Third-Millennium-Farming/domestic-cricket-reactor/README.md

domestic-cricket-reactor
========================

An inexpensive and easy to build cricket reactor for your home.  

for more infomrmation please visit. http://www.thirdmillenniumfarming.com/4.-Products.Cricket-Reactor.Features.html
