Third-Millennium-Farming/domestic-cricket-reactor/(list of files, cad)

Other CAD files:
02. June29.3dPrint.dwg
01. June29.LaserCut.dwg
