Third-Millennium-Farming/domestic-cricket-reactor/03. Assembly Manual.pdf

# MATERIALS LIST

Obtain the following materials before begining assembly:

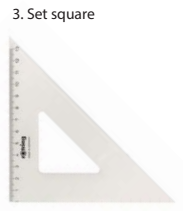
[picture p1: figure]

1. Acrylic Glue | 2. Acrylic Glue Syringe | 3. Set square

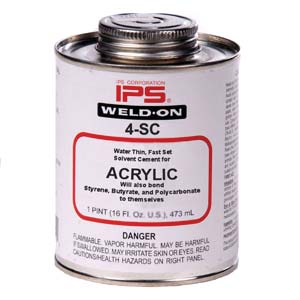
[picture p2: figure]

For acrylic gluing instructions, review the below video link: https://www.youtube.com/watch?v=hT6Ow_cBTps

4. Glue gun and glue stick

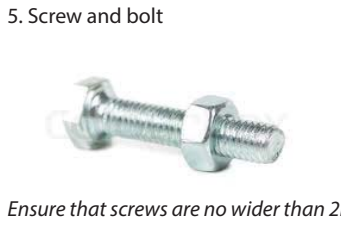
[picture p3: figure]
5. Screw and bolt

Ensure that screws are no wider than 2mm, and at least 15mm long.

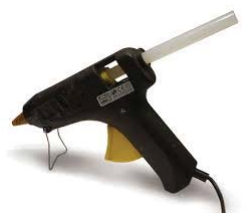
[picture p4: figure]

# PLEXI-GLASS PART LIST

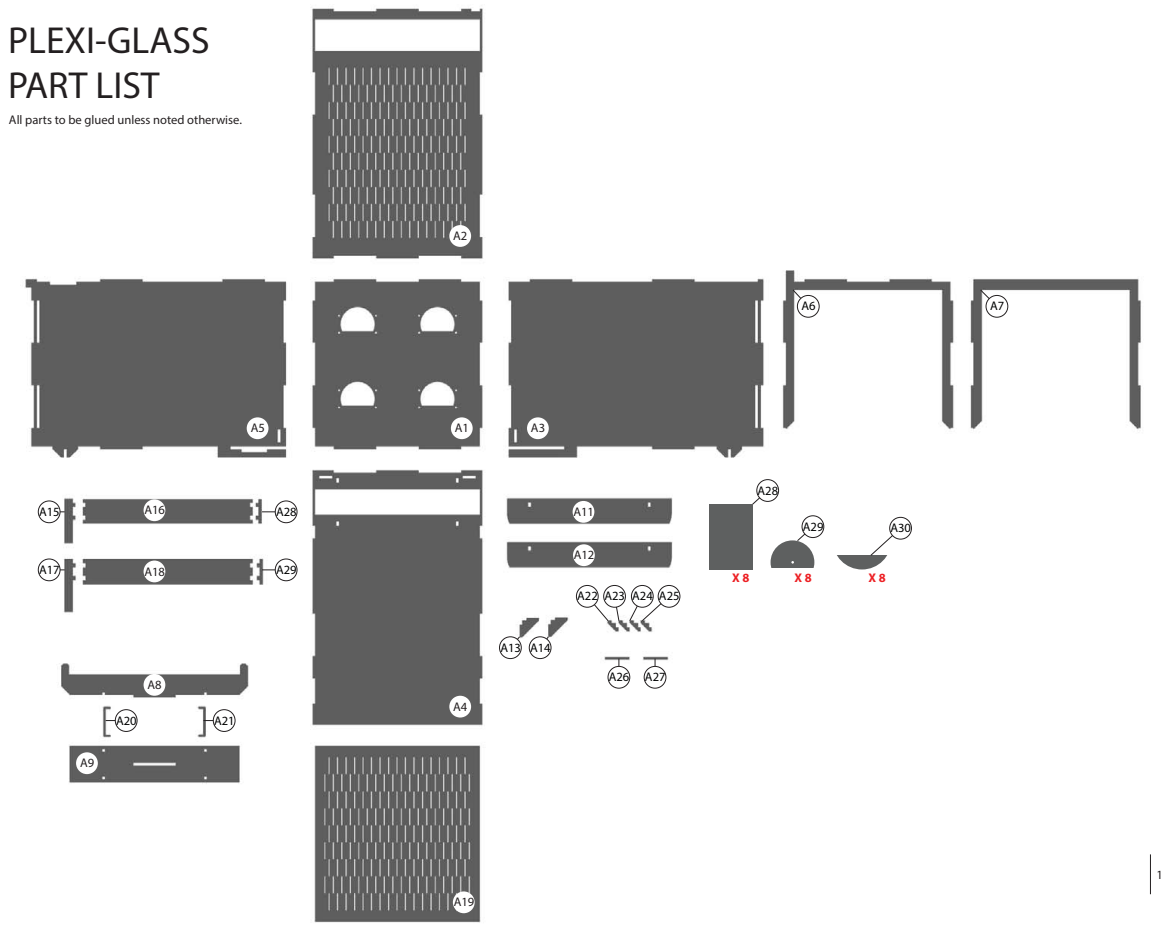
[picture p5: page 2]

All parts to be glued unless noted otherwise.

01 02

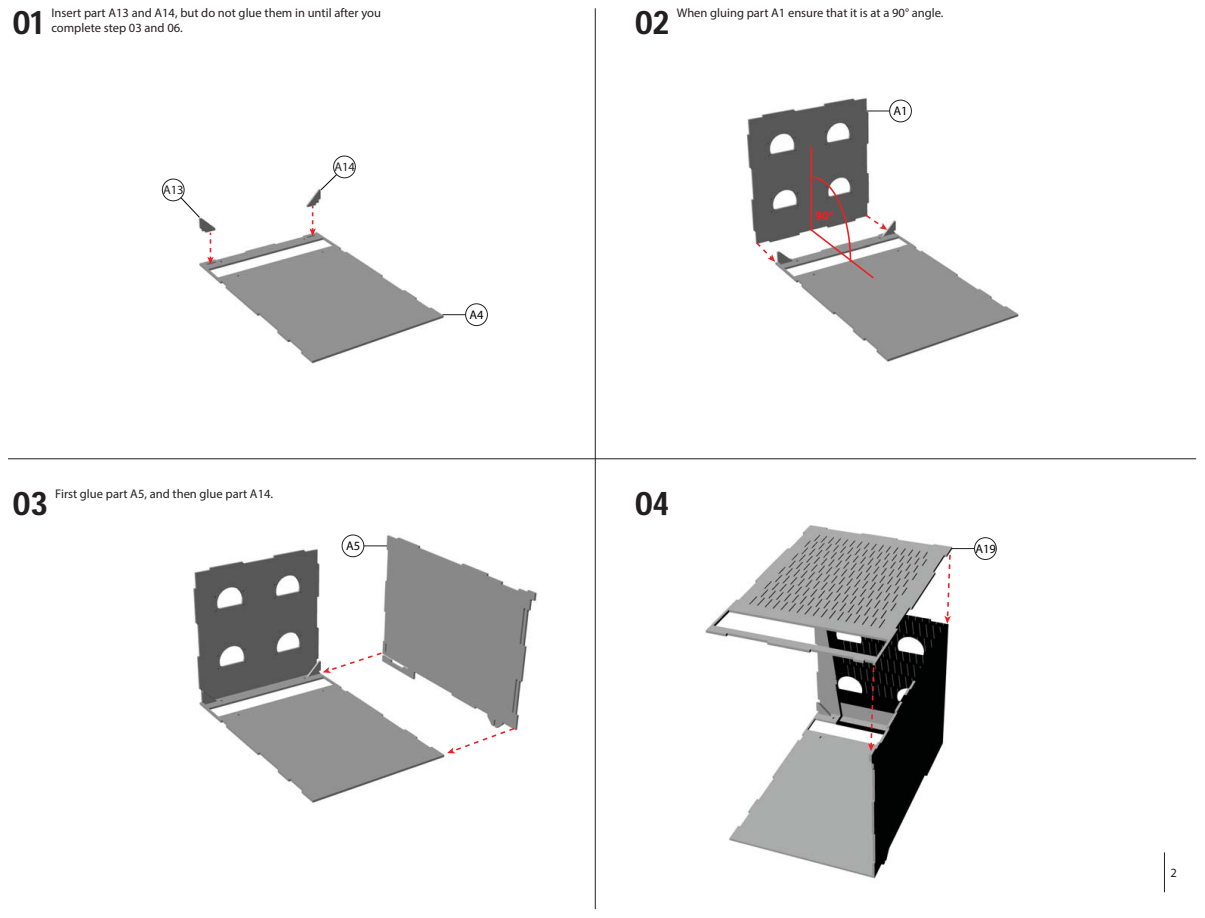
[picture p6: page 3]

Insert part A13 and A14, but do not glue them in until after you
complete step 03 and 06.

When gluing part A1 ensure that it is at a 90° angle.

First glue part A5, and then glue part A14.

06

05

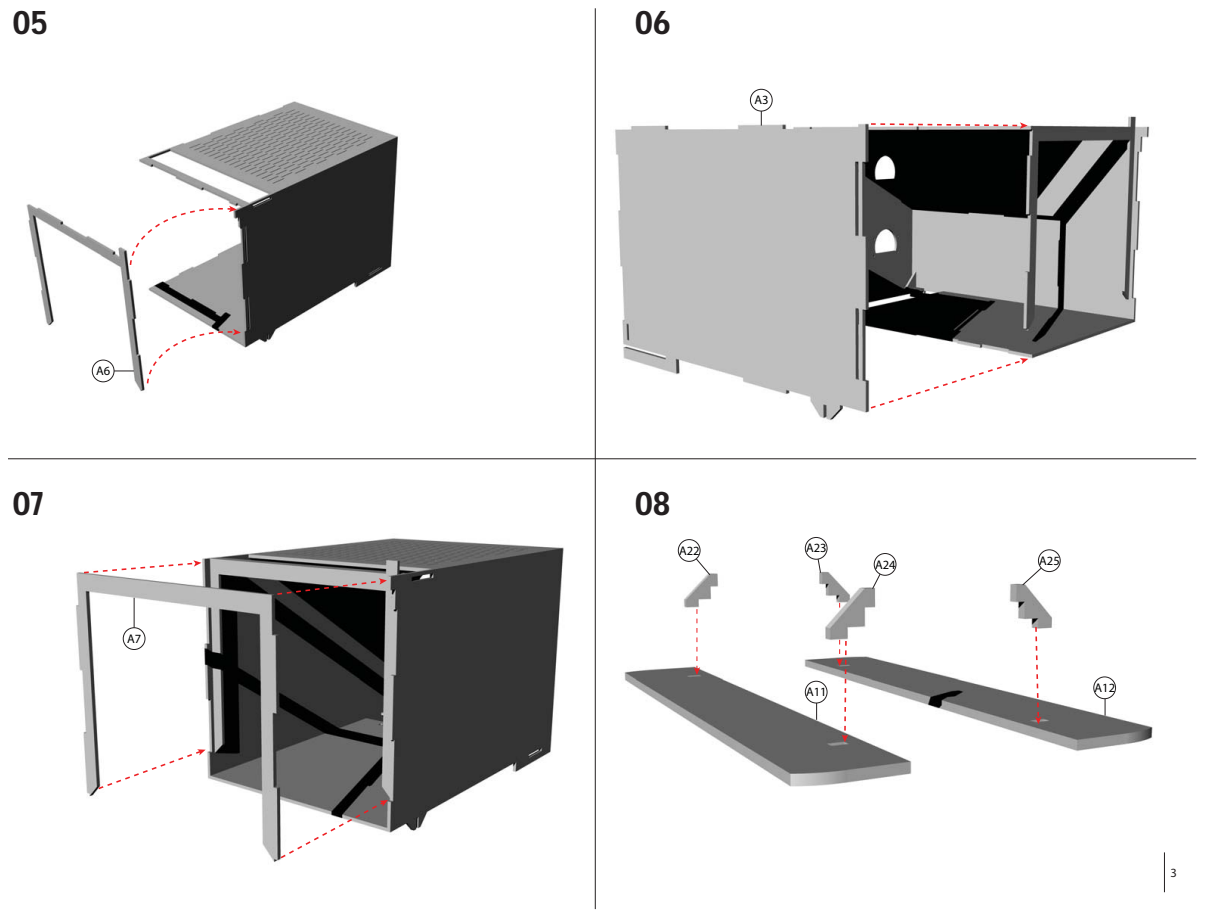
[picture p7: page 4]

10

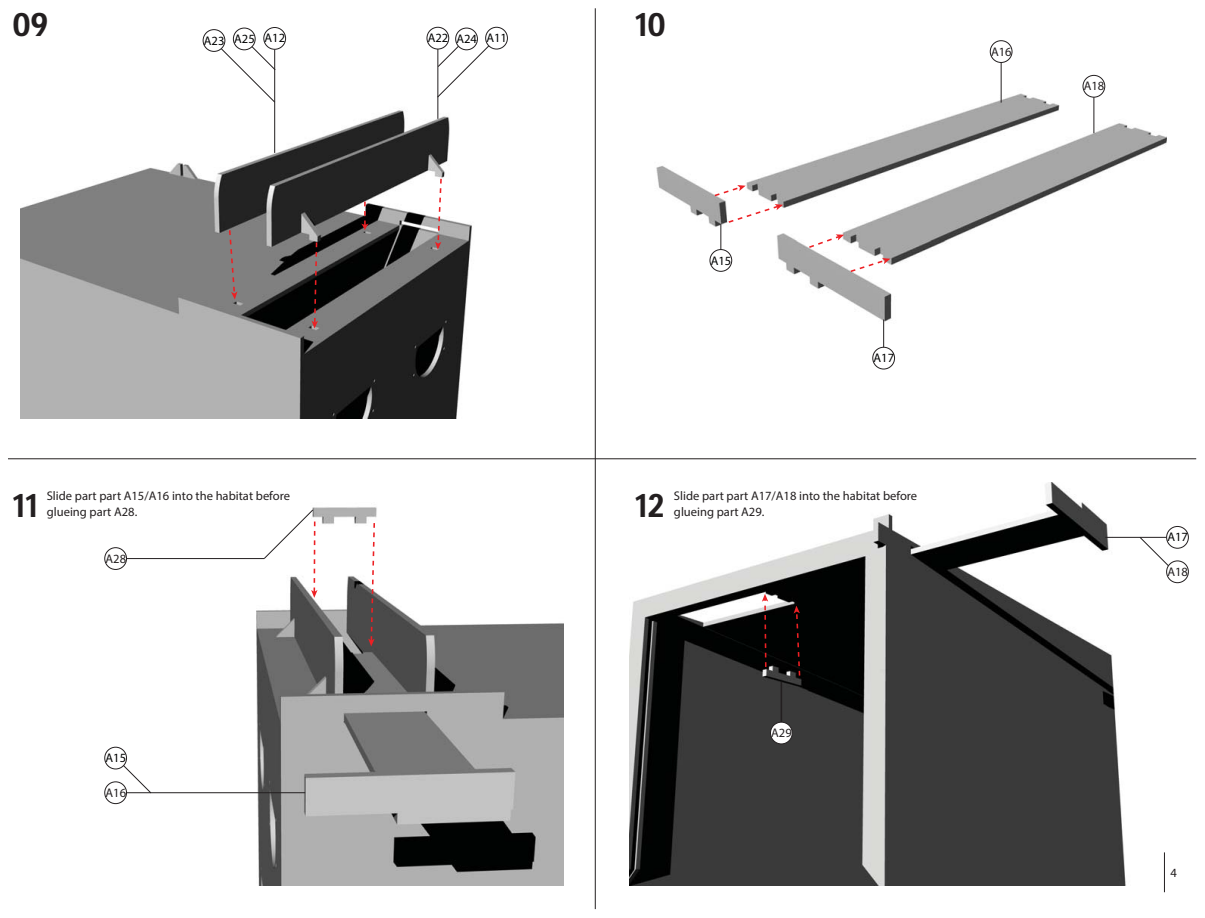
[picture p8: page 5]

Slide part part A15/A16 into the habitat before
glueing part A28.

Slide part part A17/A18 into the habitat before
glueing part A29.

13 14

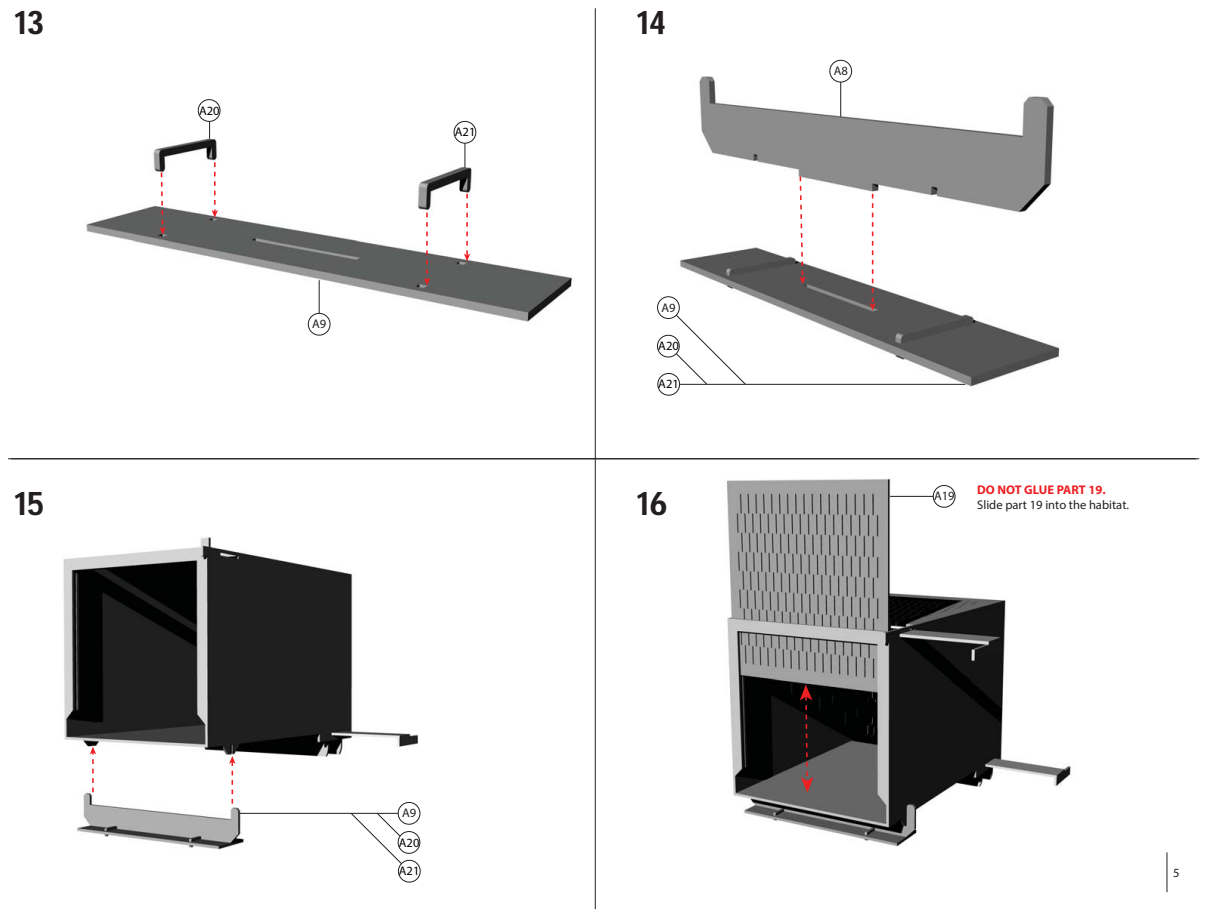
[picture p9: page 6]
DO NOT GLUE PART 19. Slide part 19 into the habitat.

17 18

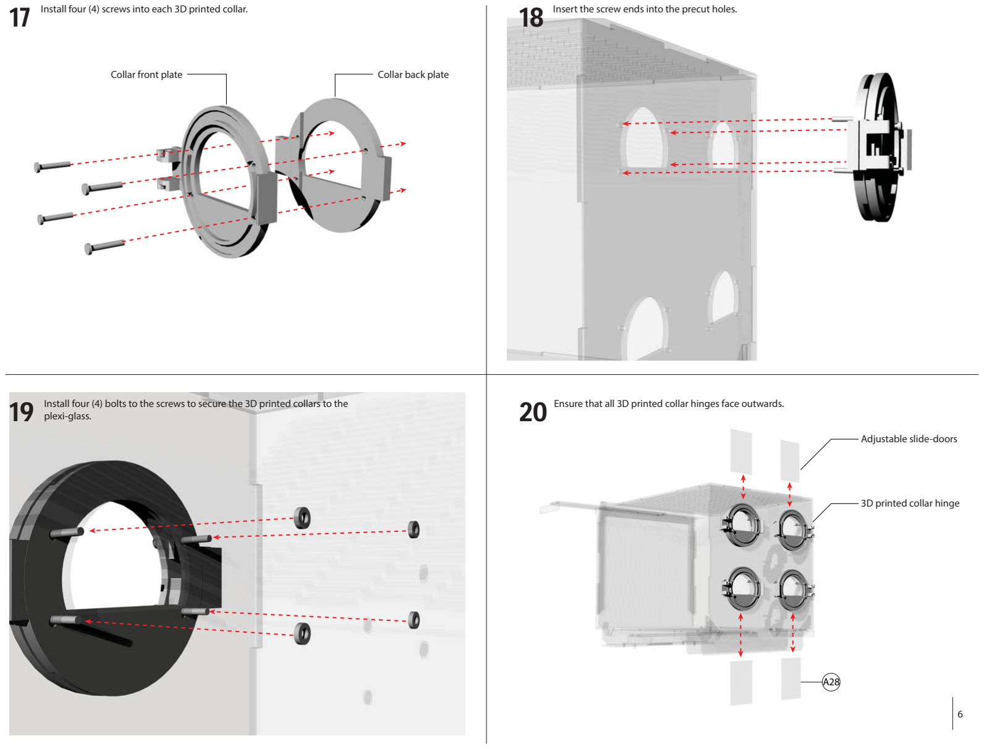
[picture p10: page 7]

A28

19 20

Install four (4) screws into each 3D printed collar.

Install four (4) bolts to the screws to secure the 3D printed collars to the
plexi-glass.

Insert the screw ends into the precut holes.

Collar front plate | Collar back plate

Ensure that all 3D printed collar hinges face outwards.

3D printed collar hinge

Adjustable slide-doors

21 22

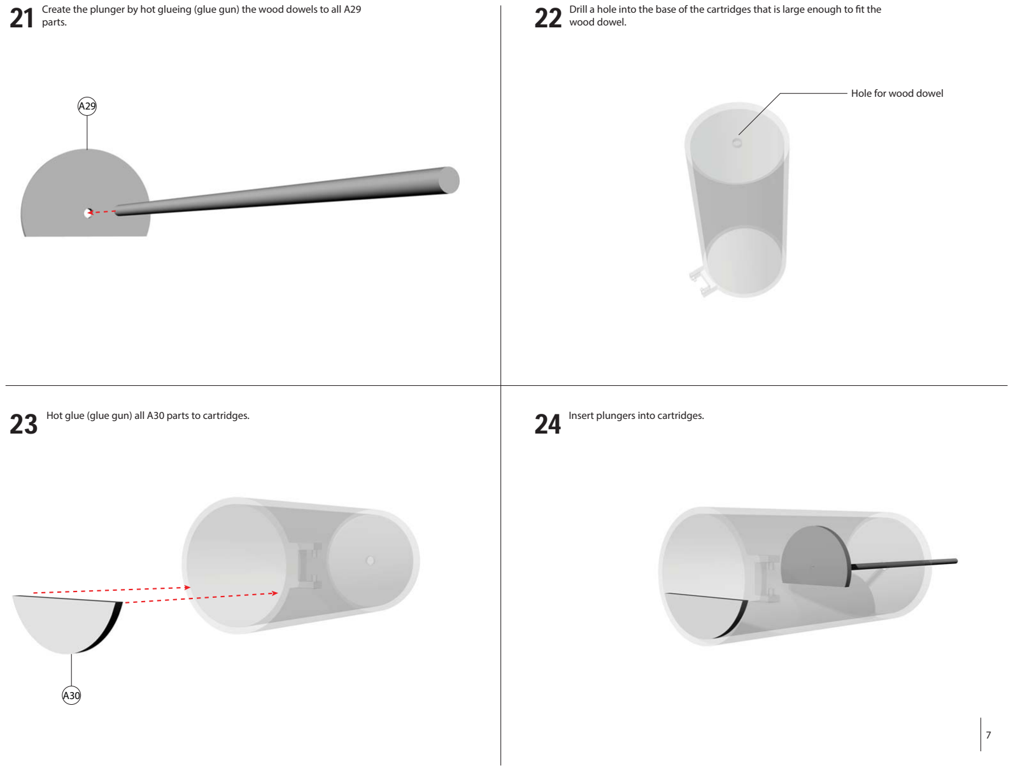
[picture p11: page 8]

A29

A30

23 24

Create the plunger by hot glueing (glue gun) the wood dowels to all A29 parts.

Drill a hole into the base of the cartridges that is large enough to fit the wood dowel.

Hole for wood dowel

Hot glue (glue gun) all A30 parts to cartridges. | Insert plungers into cartridges.

25 26

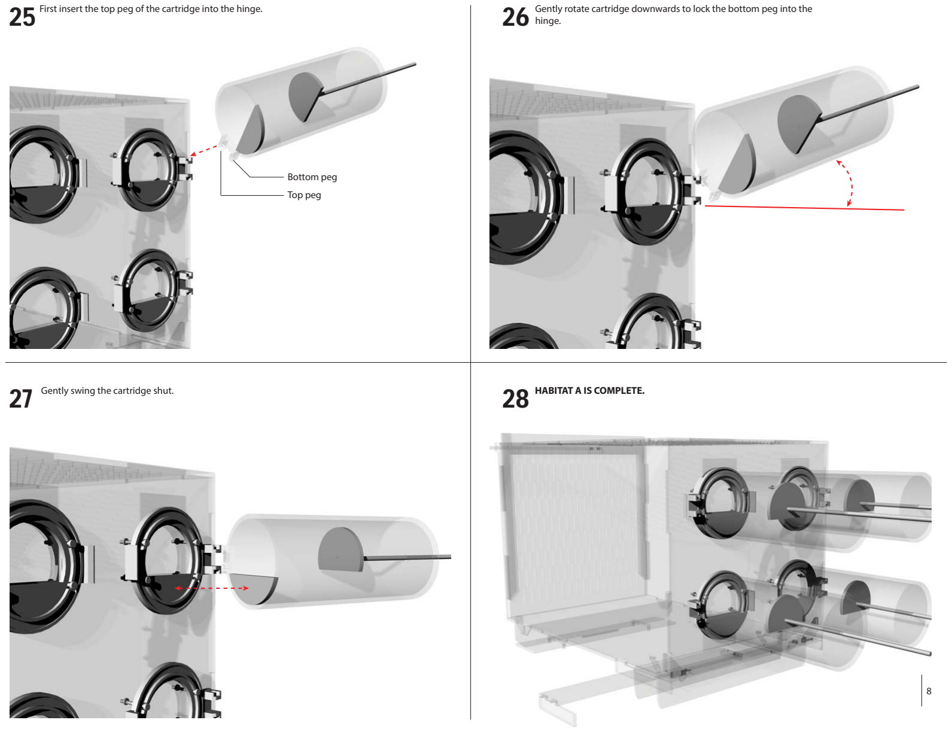
[picture p12: page 9]

27 28

First insert the top peg of the cartridge into the hinge. | Gently rotate cartridge downwards to lock the bottom peg into the hinge.

Top peg

Bottom peg

Gently swing the cartridge shut. | HABITAT A IS COMPLETE.
